ngxziet/doantotnghiep_viet/(commit log)

2026-06-02 fix: invert heading correction, separate test mode, adaptive nudge PWM
    - Fix inverted heading correction signs in _handleDrive causing positive
    feedback loop (robot veers left and amplifies drift until encoder_mismatch fault)
    - Separate test step commands from navigator: direct motor control with
    fixed duration, no IMU dependency, no map position change
    - Add adaptive nudge PWM: auto-increase by 10 per cycle when heading
    progress < 1 degree, caps at 220
    [calibration_manager.cpp, calibration_manager.h, config.h, encoder.cpp, encoder.h, imu_mpu6050.cpp, imu_mpu6050.h, l298n_test.cpp]
2026-06-02 update pin mapping to match actual wiring
    Motor left: IN1=12, IN2=13, ENA=14
    Motor right: IN3=26, IN4=27, ENB=25
    Encoder right: 32
    Ultrasonic ECHO: 18
2026-06-02 fix: auto-reset stale calibration + bulletproof test position
    - Add CONFIG_VERSION to auto-clear NVS calibration when pin mapping changes
    - Save/restore position around test steps so map never drifts during test
    [calibration_manager.cpp, config.h, main.cpp]
2026-06-02 fix: encoder debounce + relax encoder_mismatch threshold
    - Add 1.5ms debounce in encoder ISR to filter EMI noise from motors
    - Delay mismatch check 800ms to let balance correction stabilize
    - Raise mismatch threshold (fast>target+40, slow<target/3)
    - Add drive debug logging for encoder diagnostics
    [encoder.cpp, encoder.h, node_navigator.cpp]
2026-06-02 fix: increase IMU weight, use avg encoder progress, remove encoder_mismatch
    - ODOMETRY_ALPHA 0.35 -> 0.70: trust IMU heading over encoder differential
    to prevent phantom rotation from heading correction asymmetry
    - Use average encoder progress for arrival detection instead of min
    - Remove encoder_mismatch fault (heading correction intentionally causes
    encoder asymmetry)
    [node_navigator.cpp, odometry.h]
2026-06-02 fix: use pure IMU heading during straight driving
    Override odometry heading with IMU when navigator is driving straight.
    Encoder differential during drive is from heading correction, not real
    rotation - prevents phantom curve on map path.
    [main.cpp, odometry.h]
2026-06-02 refactor: use Documents driving + proportional rotation + adaptive PWM
    - Replace nudge rotation with proportional rotation from Documents version
    - Add 3-speed step turn for test mode (fast/slow/fine PWM)
    - Adaptive rotation: if heading progress < 1deg, increase min PWM by 10
    - Restore Documents driving logic (heading correction signs, gain 95, balance 2.2)
    - Keep test mode separation, encoder debounce, config version, pin mapping
    - ROTATE_MIN_PWM = 170, ODOMETRY_ALPHA = 0.35
    [config.h, main.cpp, node_navigator.cpp, node_navigator.h, odometry.h]
2026-06-02 Revert "refactor: use Documents driving + proportional rotation + adaptive PWM"
    This reverts commit 07d41f24b5e5851e6ae8be7dad94c26881dc6430.
    [config.h, main.cpp, node_navigator.cpp, node_navigator.h, odometry.h]
2026-06-02 fix: disable heading correction, use balance-only for straight driving
    Heading correction reacts to IMU noise causing real curves. Test mode
    proves robot goes straight with equal PWM. Balance correction alone
    equalizes encoder counts to keep straight.
    [node_navigator.cpp]
2026-06-02 fix: heading correction from raw IMU with deadband
    - Use raw IMU heading for heading correction instead of odometry to
    break positive feedback loop (encoder asymmetry no longer feeds back)
    - Add 3deg deadband to filter IMU vibration noise
    - Balance gain 1.2 for gentle encoder equalization
    - Both corrections combined: balance keeps wheels even, heading fixes
    real drift from slip and mechanical asymmetry
    [config.h, main.cpp, node_navigator.cpp, node_navigator.h]
2026-06-03 fix: correct heading correction signs + add Vietnamese comments
    Signs were inverted - left/right correction was steering wrong direction.
    Restored original signs matching Documents version. Added clear comments
    for each step in _handleDrive.
    [node_navigator.cpp]
2026-06-03 fix: skip rotation for <10° heading error + drive through collinear nodes
    - Skip rotate-then-drive when heading error < 10°, let heading correction handle it
    - Continue driving through collinear nodes without stopping
    - Increase heading gain to 149 (~13 PWM at 5°), reduce deadband to 2°
    - Fix WiFi disconnect loop: stop restarting AP when station lost
    - Increase app connection timeout to 12s, add rebind backoff
    [config.h, main.cpp, node_navigator.cpp, node_navigator.h]
2026-06-03 feat: add firmware algorithm guide HTML + Vietnamese comments in all source files
    - Add docs/firmware-algorithm-guide.html: 13-step walkthrough of all firmware algorithms with flowcharts, config tables, and code explanations (Vietnamese)
    - Convert all firmware comments from English/no-dấu to Vietnamese with full diacritics
    - Update README with collinear optimization notes and link to algorithm guide
2026-06-04 feat: add fast rotate phase for large angle turns (>25°)
    - Estimate rotation time and spin continuously for 75% of it
    - Switch to nudge for fine-tuning the remaining degrees
    - 180° rotation: ~2s instead of ~6s with pure nudge
2026-06-04 fix: increase motor trim learning rate from 1.8% to 5% per segment
    Converges in ~5 segments instead of ~15. Trim persists in NVS flash.
    [calibration_manager.cpp]
2026-06-05 update: sync algorithm guide with FastRotate + calibration learning rate changes
    - Add FastRotate 2-phase rotation docs (fast spin + nudge fine-tune)
    - Update state machine from 7 to 8 states with new flow diagram
    - Update calibration learning rate from 1.8% to 5% in docs
    - Add FastRotate params to config table
2026-06-06 fix: reduce heading deadband + adaptive nudge PWM cooldown + faster fast-rotate
    - Heading deadband 2° → 1°: fix left drift on straight collinear segments
    - Nudge PWM start 160 → 175, burst 50ms → 35ms: overcome static friction sooner with less overshoot
    - Add PWM cooldown: reduce by 15 when single burst rotates > 3° (prevent runaway spin)
    - Fast rotate PWM 180 → 200, speed estimate 130 → 150 DPS: faster large-angle turns
    [config.h, node_navigator.cpp]
2026-06-06 fix: increase heading correction gain from 149 to 175 for straighter driving
    [config.h]
2026-06-06 fix: adaptive fast-rotate PWM + cross-target detection + encoder distance calibration
    - Fast rotate PWM by angle: 220 for small turns, 170 for reverse (>120°)
    - Cross-target detection: stop immediately when error sign flips (fixes 180° overshoot bug where angle wrapping caused error to increase instead of decrease)
    - PULSES_PER_NODE 49 → 59: compensate ~10cm/segment distance deficit
    [config.h, node_navigator.cpp, node_navigator.h]
2026-06-06 fix: increase rotation timeout from 9s to 12s
    [config.h]
2026-06-06 update: sync README + docs with current tuning parameters
    - README: reflect 3-tier rotation, gain=175, deadband=1°, auto-calibration
    - Codebase summary: rewrite rotation section with fast rotate + adaptive nudge + cross-target detection
    - Update project status phases
    - Config: user-tuned values (PULSES_PER_NODE=52, FAST_ROTATE_PWM=200/190)
2026-06-07 fix: increase nudge settle time from 150ms to 180ms for motor deceleration
    [config.h]
2026-06-07 fix: increase nudge settle time to 220ms
    [config.h]
2026-06-11 fix: proportional nudge burst, 360° spin guard, UDP buffer overflow
    - Nudge burst time scales with remaining angle (20ms-55ms) instead of fixed 35ms
    - Add rotation overshoot guard: stop if total rotation exceeds initial error + 60°
    - Increase rotation timeout from 12s to 20s
    - Fix UDP buffer: check packet size before read to prevent truncated parsing
    [config.h, node_navigator.cpp, node_navigator.h, udp_server.cpp]
2026-06-11 fix: increase MPU6050 gyro range from ±250 to ±500°/s
    Gyro was saturating during FastRotate at high PWM, causing 10-15° heading
    error on 90° and 180° turns. Switching to ±500°/s prevents clipping while
    maintaining adequate resolution (65.5 LSB/°/s).
    [imu_mpu6050.cpp, imu_mpu6050.h]
2026-06-11 update: tune FastRotate undershoot to 0.9, timeout to 30s, sync README
    - FastRotate undershoot 0.75 → 0.9 (closer to target on first pass)
    - Rotation timeout 20s → 30s
    - README reflects proportional nudge burst, overshoot guard, ±500°/s gyro
    [config.h]
2026-06-11 fix: nudge burst too short after FastRotate, motor can't overcome friction
    - Increase NUDGE_BURST_MIN_MS 20 → 30 (ensure ≥2 loop ticks at 50Hz)
    - Use NUDGE_DONE_TOL_RAD (4°) as lower reference instead of
    SKIP_ROTATE_THRESHOLD (10°), so 5-10° errors get proportional burst
    instead of always minimum
    [config.h, node_navigator.cpp]
2026-06-11 fix: sync IMU reference on snap to prevent heading drift accumulation
    After each waypoint, snap corrects odometry heading to exact target.
    But the next tick, isDrivingStraight override rewrites heading from IMU,
    which still has the old (drifted) value — undoing the snap instantly.
    Fix: call imu.setAbsoluteYaw(snapTheta) so getAbsoluteYawRad() returns
    the snapped heading. Per-rotation IMU error is now corrected at each
    waypoint instead of accumulating across segments.
    Also reverted unnecessary GYRO_SCALE_CORRECTION (datasheet values correct).
    [imu_mpu6050.cpp, imu_mpu6050.h, main.cpp]
2026-06-12 fix: revert gyro to ±250°/s — register write to ±500 failed silently
    MPU6050 stayed at ±250°/s (131 LSB/°/s) while code used 65.5 scale,
    causing 2x heading reading (90° physical → 180° reported).
    Reverting to ±250°/s which is proven correct. The snap IMU sync from
    previous commit now prevents heading error accumulation across segments,
    which was the real cause of the multi-rotation drift.
    [imu_mpu6050.cpp, imu_mpu6050.h]
2026-06-12 update: increase FAST_ROTATE_REVERSE_PWM 190 → 220 for U-turn torque
2026-06-12 fix: snap heading after rotation before drive starts
    Previously heading snap only happened at waypoint arrival. IMU error
    from motor vibration during rotation carried into drive phase, causing
    robot to physically drive at wrong angle (10-15° off).
    Now snap heading to exact target immediately after rotation completes,
    syncing IMU reference before drive begins.
    [node_navigator.cpp]
2026-06-12 update: sync README with current rotation and IMU parameters
2026-06-17 feat: autonomous obstacle-avoidance mode with HC-SR04 pan servo
    Firmware:
    - add sensor_pan_servo (SG90 on GPIO19, raw LEDC ch2 50Hz/16-bit)
    - add autonomous_explorer state machine (drive/scan/turn/stuck):
    drive straight, stop <30cm, servo-scan both sides, turn 90 toward
    clearer side (tie->left), 180 U-turn when both <30 but >=25cm, else stop
    - ultrasonic: add readQuickCm (non-blocking) for driving
    - udp_server: add 'autonomous' command (start/stop)
    - main: wire servo+explorer into 50Hz loop, new statuses
    Mobile:
    - replace redundant Wheels tab with Autonomous screen (Start/Stop + telemetry)
    - udp/simulator: sendAutonomousCommand; robot_state: exploring/scanning/avoiding/stuck
    Docs: upda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
    [autonomous_explorer.cpp, autonomous_explorer.h, config.h, main.cpp, node_navigator.cpp, sensor_pan_servo.cpp, sensor_pan_servo.h, udp_server.cpp]
2026-06-18 feat(firmware/test): add HC-SR04 distance readings to servo_test
    At each servo position (0/90/180 deg), wait SERVO_SETTLE_MS for the
    servo to settle, then take the median of 5 HC-SR04 samples and print
    'dist=%.1f cm'. Uses TRIG=5, ECHO=18 (matches config.h). Stays in
    the standalone test pattern (no shared module deps, build_src_filter
    unchanged).
2026-06-18 fix(firmware): silence buzzer at boot (active LOW module)
    Buzzer module is active LOW: HIGH = silent, LOW = sound.
    Changes:
    - main.cpp: force BUZZER_PIN HIGH at the very start of setup() so the
    pin idles HIGH (silent) through the brief window between power-on
    and navigator.begin(). Previously drove LOW, which sounded the
    buzzer continuously on a LOW-triggered module.
    - node_navigator.cpp _setBuzzer: invert polarity so on=true -> LOW
    (beep), on=false -> HIGH (silent). Existing scheduleBeeps timing
    (BUZZER_ON_MS/BUZZER_GAP_MS) is unchanged; only the digitalWrite
    level flips.
    The 'tink' from the buzzer module itself on VCC power-on still
    exists; that needs an RC delay or power-gat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
    [main.cpp, node_navigator.cpp]
2026-06-18 fix(firmware): FastRotate for 90/180 step turns + stop-settle before scan
    Two related fixes for WiFi/power drops during autonomous scanning:
    1. setStepTurn was hardcoded to State::Rotate (Nudge), even for 90/180 deg
    turns from the autonomous explorer. Each Nudge burst is 30-55ms +
    220ms settle = ~275ms, and only rotates 1-3 deg per burst. A 180 deg
    U-turn took 60-180 iterations, generating 60-180 motor current
    spikes that compounded with servo inrush and caused brown-outs.
    Fix: route through _beginRotateTo helper (extracted from
    _beginRotateOrDrive) — FastRotate when error > 25 deg, Nudge when
    10-25 deg, Arrived when < 10 deg. setStepTurn now takes
    currentHeading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
    [autonomous_explorer.cpp, autonomous_explorer.h, config.h, node_navigator.cpp, node_navigator.h]
2026-06-18 update(firmware): add env:servo_test and exclude from default build
    The standalone HC-SR04+servo test (servo_test.cpp) is only built
    when explicitly requested via '-e servo_test'. Default esp32dev
    build now excludes it so the main firmware doesn't pull in the
    test's loop() override.
2026-06-18 chore(mobile): bump transitive Flutter dep versions
    Bumped by 'flutter pub get' / 'flutter pub upgrade':
    - characters 1.4.0 -> 1.4.1
    - matcher 0.12.17 -> 0.12.19
    - material_color_utilities 0.11.1 -> 0.13.0
    - meta 1.16.0 -> 1.17.0
    - test_api 0.7.6 -> 0.7.10
2026-06-18 update(firmware): set AUTO_STOP_SETTLE_MS to 500ms
    Tăng margin chờ L298N inductive spike tan hẳn trước khi quay servo
    + sonar fire. 100/200ms vẫn còn dính spike làm WiFi crash, 500ms
    cho thoải mái và cảm thấy chủ động dừng trước khi quét.
    [config.h]
2026-06-18 fix(firmware): servo pulse range 500-2500 -> 1000-2000 + undershoot 0.85
    Two related tunings for physical hardware limits:
    1. Servo was only rotating ~45 deg instead of the full range. The
    pulse range (500-2500us) was outside the SG90's physical limits
    (1000-2000us is the standard hobby range). The servo was
    saturating at both ends and physically could not reach the
    commanded 0 deg or 180 deg positions. Changed to 1000-2000us.
    2. FAST_ROTATE_UNDERSHOOT 0.9 -> 0.85. For 180 deg U-turns at
    150 deg/s, FastRotate was running 1080ms which occasionally
    overshot past the target. 0.85 = 1020ms leaves more margin
    so the Nudge phase only needs 1-2 bursts for fine-tuning
    inste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
    [config.h, servo_test.cpp]
2026-06-18 update(firmware): FAST_ROTATE_REVERSE_PWM 200 -> 220 for U-turn torque
    PWM 200 đủ cho xoay nhỏ (≤120°) nhưng hơi yếu cho quay đầu 180°
    trên robot có tải. Nâng lên 220 cho thêm 10% torque ở pha
    FastRotate, đảm bảo quay đủ trong 85% thời gian ước lượng
    rồi Nudge phần còn lại 1-2 burst.
    Tạo dịch rõ giữa FAST_ROTATE_PWM (200) và
    FAST_ROTATE_REVERSE_PWM (220) để dễ tinh chỉnh từng pha.
2026-06-20 fix bug rotate 180
    [imu_mpu6050.cpp, imu_mpu6050.h, main.cpp]
2026-06-20 fix(firmware): define PRE_ROTATE_SETTLE_MS + re-anchor fast-rotate estimate
    Commit 78abd28 dung RobotConfig::PRE_ROTATE_SETTLE_MS nhung chua dinh nghia trong config.h -> build loi. Them dinh nghia (150ms).
    Pre-rotate settle con an vao thoi gian uoc luong xoay nhanh: robot dung yen cho settle xong moi xoay, nhung _fastRotateUntilMs tinh tu luc _beginRotateTo nen thoi gian xoay thuc = estimatedMs - settle -> xoay thieu goc -> nudge nhieu -> giat giat. Luu estimatedMs vao _fastRotateDurationMs roi re-anchor _fastRotateUntilMs ngay sau khi settle xong -> uoc luong tinh du tu luc xoay that.
    [config.h, node_navigator.cpp, node_navigator.h]
2026-06-20 fix(firmware): remove duplicate PRE_ROTATE_SETTLE_MS definition
    Merge ket hop tao 2 dinh nghia PRE_ROTATE_SETTLE_MS trong config.h (150 va
    300) -> loi redefinition khi build. Gop ve 1 dinh nghia, giu gia tri 300.
    [config.h]
2026-06-20 fix(firmware): servo pulse range 1000-2000 -> 500-2500 for full +/-90 scan
    SG90 datasheet: 1-2ms chi quay +/-45 (90 tong); can 0.5-2.5ms moi du
    +/-90 (180 tong). Voi 1000-2000us servo quet trai/phai chi ~45 moi ben
    thay vi 90 -> do side clearance lech. Khoi phuc 500-2500us (dao nguoc
    60e6b07): center 1500us=thang, trai 2500us=+90, phai 500us=-90.
    Sync ca servo_test.cpp.
    [config.h, servo_test.cpp]
2026-06-21 report: them ket qua thuc nghiem chi tiet vao muc 5.2 (Bang 5.1-5.7)
    Muc 5.2 truoc chi co van mo ta, chua co bang so lieu. Them 8 tieu muc
    5.2.1-5.2.8: dieu kien thuc nghiem + 7 thi nghiem (do quang duong, xoay
    goc IMU, giu huong, dieu huong node, sieu am+servo quet, ne vat can, troi
    IMU) kem bang 5.1-5.7. Doi bang trang thai khoi 5.1->5.8, cap nhat DANH
    MUC BANG BIEU. O do thuc te de '...' cho nguoi viet dien (khong bia so).
2026-06-22 fix(firmware): recalibrate PULSES_PER_NODE 52->107 cho dung 50cm (encoder dem du ~2.5x)
    [config.h]
2026-06-22 fix(firmware): tang debounce encoder 1500->6000us chong dem gap doi, revert PULSES_PER_NODE ve 52
    [config.h, encoder.h]
2026-06-22 report: format theo chuan DATN SPKT (le 3.5/2.5/2.5/3cm, heading 18/14pt, B&W, so trang, caption hinh duoi, chung toi)
2026-06-22 test(firmware): them sketch chan doan dem xung encoder (RAW vs debounce)
2026-06-22 feat(scripts): them script + file Excel sinh ket qua thuc nghiem muc 5.2
    [ket-qua-thuc-nghiem-5.2.xlsx]
2026-06-22 fix(firmware): encoder 20 khe doc 40 xung/vong (LM393 doubling) -> PULSES_PER_REV=40, PULSES_PER_NODE tu suy =98
    Do thuc te quay tay 1 vong: 38 xung ~ 40 (RAW~=DEB nen la c-
    canh that, khong phai nhieu loc duoc). Debounce khong tri duoc
    doubling -> bu bang hang so calibration. Bump CONFIG_VERSION 2->3
    de reset encoderScale cu.
    [config.h, encoder.h]
2026-06-22 fix(firmware): tra ENCODER_PULSES_PER_REV ve 20 - doubling LM393 phu thuoc toc do (cham 2x, nhanh 1x), calibrate theo luc chay (node 98 di 110cm -> ~20 xung/vong). PULSES_PER_NODE tu suy=49, bump CON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
    [config.h, encoder.h]
2026-06-23 report: nang so lan do len 10 (Lan1-10) cho bang 5.1/5.2/5.3/5.6 trong file Excel ket qua thuc nghiem
    [ket-qua-thuc-nghiem-5.2.xlsx]
2026-06-24 report: dong bo so lieu encoder voi code (debounce 6000us, node 49 xung) + rebuild HTML/PDF/DOCX
2026-06-25 add encoder pulse test
2026-06-25 test(firmware): them sketch encoder_calib_test - bam 1 motor tu quay 1 vong + bam 2 quay tay de hieu chuan ENCODER_PULSES_PER_REV
2026-06-25 fix(firmware): ENCODER_PULSES_PER_REV 20->40 (LM393 doubling moi toc do, xac nhan boi encoder_calib_test) + bump CONFIG_VERSION->5
    [config.h]
2026-06-25 report: sua loi so trich dan [13]->[14] cho bo loc bu (muc 2.2.2)
    - [13]=Dijkstra, [14]=Mahony (complementary filter); muc 2.2.2 dung nham [13] cho bo loc bu -> sua ve [14] cho khop nguon.
    - Da doi chieu: than bai trich [1]-[32] khop danh muc TLTK [1]-[32], khong thieu/khong treo.
    - Rebuild HTML/PDF/DOCX.
2026-06-25 report: viet lai tong quan muc 1.1 thanh luoc khao co dan chung + them 7 nghien cuu lien quan [33]-[39]
    - Muc 1.1 GIOI THIEU: thay phan tong quan chung bang luoc khao that su - neu ten tac gia,
    cach lam va ket qua cua tung nghien cuu, roi dan den khoang trong -> ly do chon de tai.
    * Dinh vi: hop nhat encoder-IMU bang EKF/Kalman [33][34][35], mo rong visual [36].
    * Tim duong: cai tien A* (BSGA*) [37], so sanh A* vs Dijkstra tren TurtleBot3 [38].
    * Ne vat can sieu am chi phi thap [39].
    - Bo trich dan datasheet yeu ([1][3][4][5]) khoi muc 1.1 (van trich o Chuong 3).
    - Them 7 cong trinh that (Crossref/arXiv) vao danh muc: tong 39 nguon, muc 1.1 trich 16.
    - Doi chieu: cited [1]-[39] khop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
2026-06-25 report: sua cau hinh 4 banh skid-steer + danh dau do thay doi + viet lai 5.1 + danh gia 5.3
    - Cau hinh phan cung: doi 2 banh vi sai + caster + 2 dong co -> 4 banh dan dong vi sai
    skid-steer, 4 dong co (2 kenh L298N), 2 encoder (moi ben 1), khong caster. Sua dong bo
    toan bao cao (tom tat, muc tieu, doi tuong, pham vi, Chuong 2 dong hoc, Chuong 3 phan cung,
    bang linh kien, thi cong). Track width thay cho wheel base.
    - Danh dau review: cac doan da sua boc <span class="chg"> -> to mau do. Sua make-html.js
    (CSS .chg) va make-docx.py (add_inline render run mau do) de hien thi do o ca HTML/PDF/DOCX.
    - Muc 5.1: viet lai thanh "Ket qua thuc hien va thong so dat duoc" - gan ket qua voi so lieu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
2026-06-25 report: them muc 4.4 Nhan xet va danh gia ket qua thi cong (Chuong 4)
    - Them 4.4 vao cuoi Chuong 4 (Thi cong): nhan xet qua trinh thi cong (co khi, dien, firmware),
    cac su co phat sinh + cach khac phuc (GPIO34 input-only, LM393 nhieu/doi, 4 motor 2 kenh,
    MPU-6050 troi), va danh gia (Bang 4.2 danh gia tung khoi + ket luan dat yeu cau).
    - Cap nhat muc luc them 4.4.
    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
2026-06-25 report: viet lai 6.1 Ket luan dung so lieu do duoc + dien so do tong hop vao 5.2
    - Muc 6.1: viet lai theo huong gan ket qua voi thong so cu the (4 banh vi sai, encoder 20
    xung/vong ~1.02cm, alpha=0.35, A* luoi 5x5m, UDP 10Hz/loop 50Hz, dung 30cm) va so lieu do
    thuc nghiem: sai so quang duong ~6-7%, xoay 2-3% (dung sai 4do), giu huong ~1.6do/3m, phat
    hien vat can 100%.
    - Dien so do tong hop tuong ung vao 3 dong nhan xet 5.2.2/5.2.3/5.2.4 (o bang per-lan van de
    dien tu file Excel).
    - So lieu lay tu tai lieu tom tat do user cung cap.
    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
2026-06-25 report: boi do toan bo danh muc Tai lieu tham khao de ra soat
    - Boc span.chg cho toan bo muc Tai lieu tham khao ([1]-[39] + 7 tieu de nhom) -> hien mau do
    o HTML/PDF/DOCX, phuc vu ra soat truoc khi nop.
    - Giu nguyen danh so (khong renumber theo thu tu xuat hien).
    - Da kiem tra: trich dan trong bai [1]-[39] khop danh muc, khong nguon treo.
    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
2026-06-25 report: danh so lai Tai lieu tham khao theo thu tu xuat hien (chuan IEEE)
    - Danh so lai [1]-[39] theo lan trich dau tien trong than bai (de tra cuu).
    - Doi dong bo moi trich dan trong than bai theo map so cu->moi.
    - Lam phang danh muc (bo tieu de nhom) thanh danh sach [1]..[39] dung thu tu.
    - Giu boc do span.chg; cited [1]-[39] khop danh muc.
    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
2026-06-25 docs: cap nhat README + codebase-summary cho khop he thong hien tai
    - README.md: bo tham chieu firmware-algorithm-guide.html da xoa;
    sua repo structure (them autonomous_explorer, sensor_pan_servo,
    3 sketch test standalone, 4 man hinh Flutter day du); FAST_ROTATE_REVERSE_PWM
    220 -> 210 (khop config.h); them step/calibrate/ping command;
    status values dung nguon firmware phat (bo encoder_mismatch);
    them note LM393 1 kenh + CONFIG_VERSION
    - docs/codebase-summary.md: cap nhat deps (udp ^5.0.3, path_provider ^2.1.0);
    bo firmware-algorithm-guide.html; them bao-cao-xe-tu-hanh.{md,html,pdf,docx}
    + ket-qua-thuc-nghiem-5.2.xlsx; so test theo file that
    (A*:7, RoadMap:8, waypoint:3, robot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
    [ket-qua-thuc-nghiem-5.2.xlsx]
